adivd15/LaserScanner/README.md

# LaserScanner
College Optoelectronics Project
