adivd15/LaserScanner/HARDWARE/MECHANICS/Asembly/Motor_small_and_plate.SLDASM

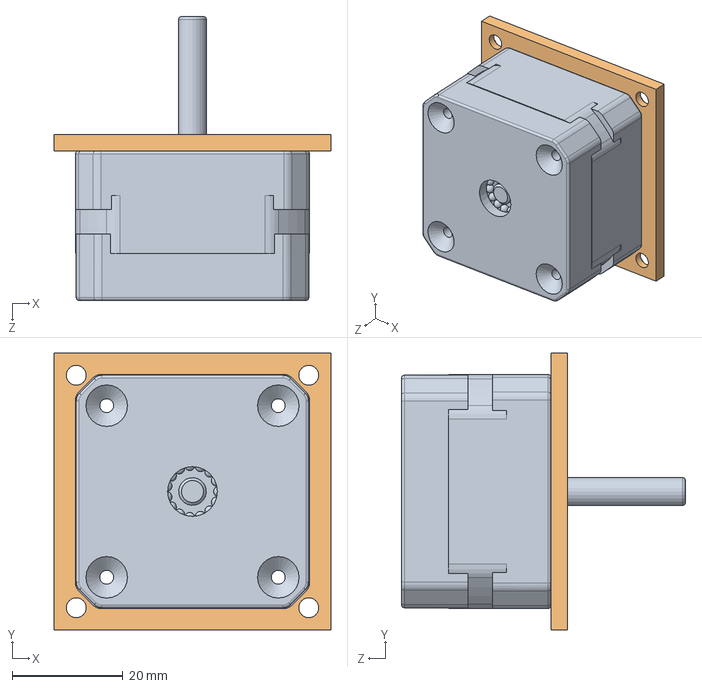
[picture p23: CAD file, 2022-12-18]
HARDWARE/MECHANICS/Asembly/Motor_small_and_plate.SLDASM
50.0 x 50.0 x 51.3 mm
NEMA_17_PHB42S28-406A v2
Plate
