adivd15/LaserScanner/HARDWARE/MECHANICS/Asembly/Motor_big_and_plate.SLDASM

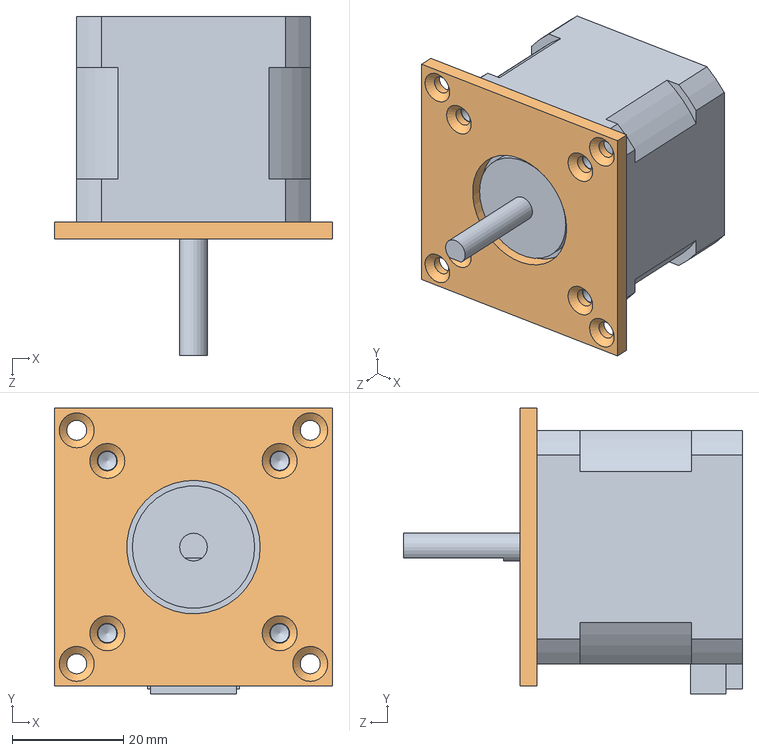
[picture p24: CAD file, 2022-12-18]
HARDWARE/MECHANICS/Asembly/Motor_big_and_plate.SLDASM
50.0 x 51.4 x 61.0 mm
NEMA17-42A02C-Body.step
Plate
