adivd15/LaserScanner/HARDWARE/MECHANICS/Asembly/Motors_and_base.SLDASM

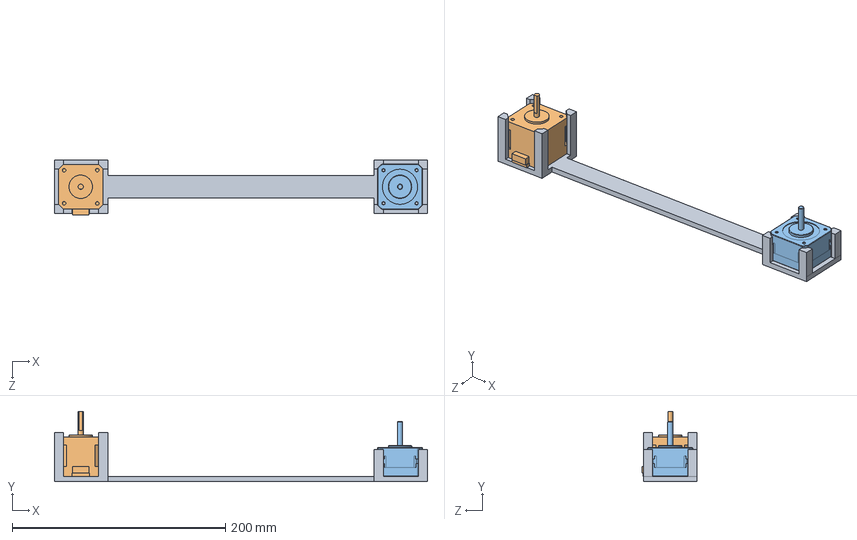
[picture p25: CAD file, 2022-12-18]
HARDWARE/MECHANICS/Asembly/Motors_and_base.SLDASM
350.0 x 66.0 x 51.4 mm
Base
NEMA17-42A02C-Body.step
NEMA_17_PHB42S28-406A v2
