adivd15/LaserScanner/HARDWARE/MECHANICS/Asembly/Scanner.SLDASM

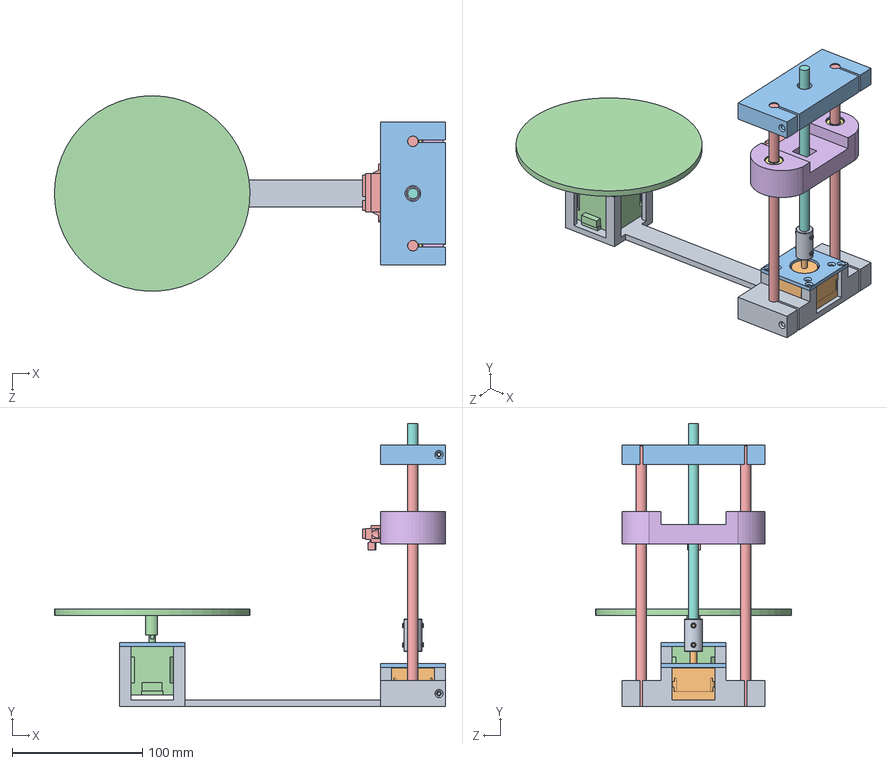
[picture p26: CAD file, 2022-12-18]
HARDWARE/MECHANICS/Asembly/Scanner.SLDASM
300.0 x 217.3 x 150.0 mm
Base
NEMA_17_PHB42S28-406A v2
Plate x 2
NEMA17-42A02C-Body.step
Axle x 2
Sensor_Mount
3.Linear Bearing-LM8UU.step x 2
Threaded_rod_8mm
Shaft Coupler.step
M4 x 4mm Cup-Point Set Screw.step x 4
Retention_hat
Scanner_plate
Long Range SHARP IR Sensors - #GP2Y0A21YK0F.step
