adivd15/LaserScanner/HARDWARE/MECHANICS/External parts/Long Range SHARP IR Sensors - #GP2Y0A21YK0F.STEP

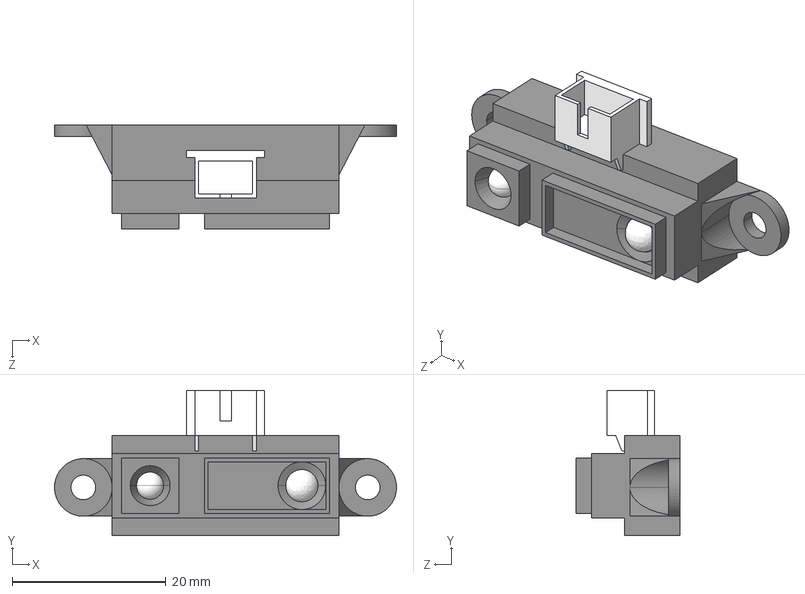
[picture p27: CAD file, 2022-12-18]
HARDWARE/MECHANICS/External parts/Long Range SHARP IR Sensors - #GP2Y0A21YK0F.STEP
44.5 x 18.9 x 13.5 mm
