adivd15/LaserScanner/HARDWARE/MECHANICS/Parts/Axle.SLDPRT

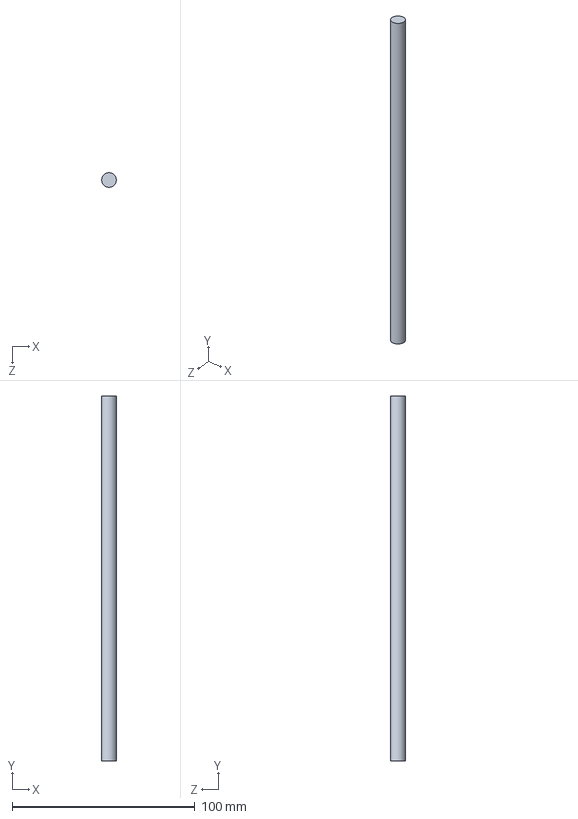
[picture p28: CAD file, 2022-12-18]
HARDWARE/MECHANICS/Parts/Axle.SLDPRT
8.00 x 200.0 x 8.00 mm
