adivd15/LaserScanner/HARDWARE/MECHANICS/To be 3D printed/base_first_half.stl

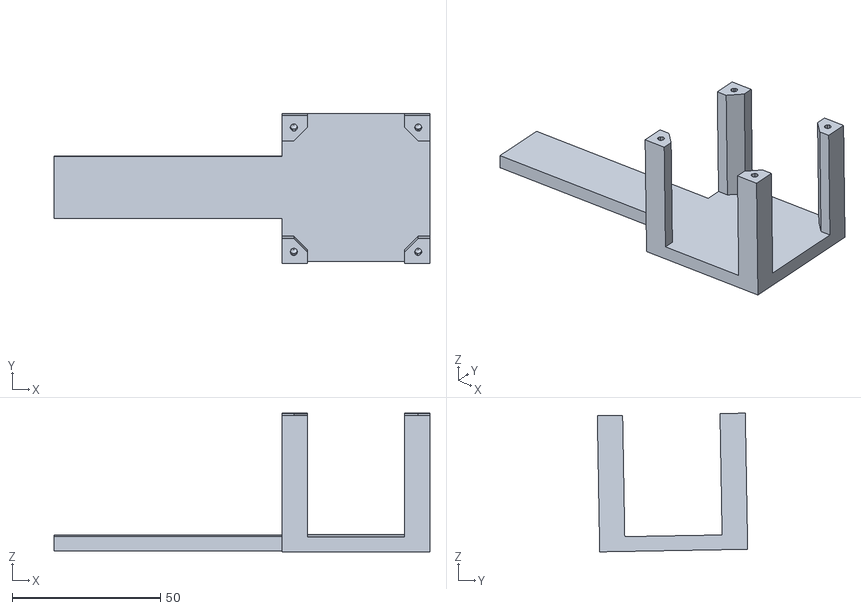
[picture p29: CAD file, 2022-12-18]
HARDWARE/MECHANICS/To be 3D printed/base_first_half.stl
127.0 x 50.8 x 46.9
