adivd15/LaserScanner/HARDWARE/MECHANICS/External parts/NEMA17-42A0C.step

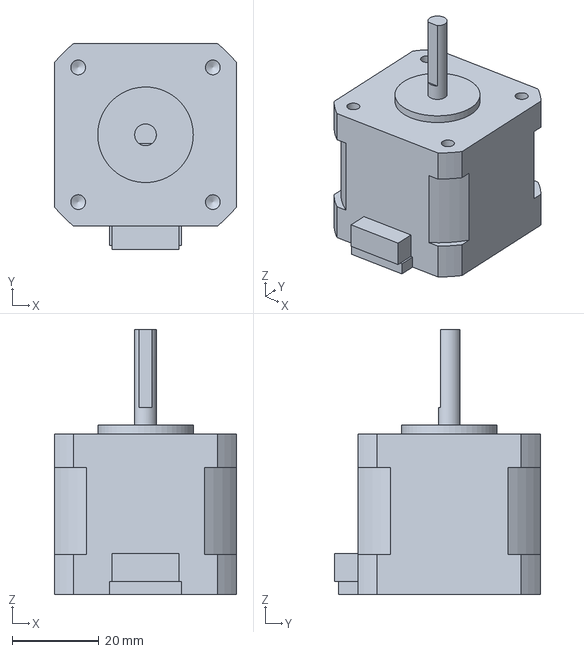
[picture p30: CAD file, 2022-12-18]
HARDWARE/MECHANICS/External parts/NEMA17-42A0C.step
42.0 x 47.4 x 61.0 mm
