adivd15/LaserScanner/HARDWARE/MECHANICS/Parts/Scanner_plate.SLDPRT

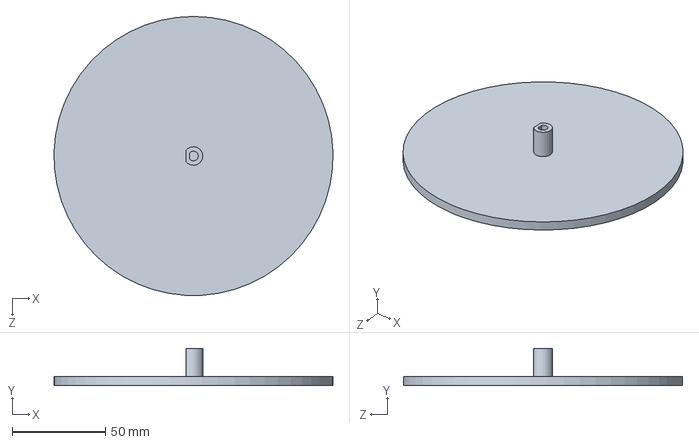
[picture p31: CAD file, 2022-12-18]
HARDWARE/MECHANICS/Parts/Scanner_plate.SLDPRT
149.9 x 20.0 x 150.0 mm
