adivd15/LaserScanner/HARDWARE/MECHANICS/To be 3D printed/Base_second_half_update_2.stl

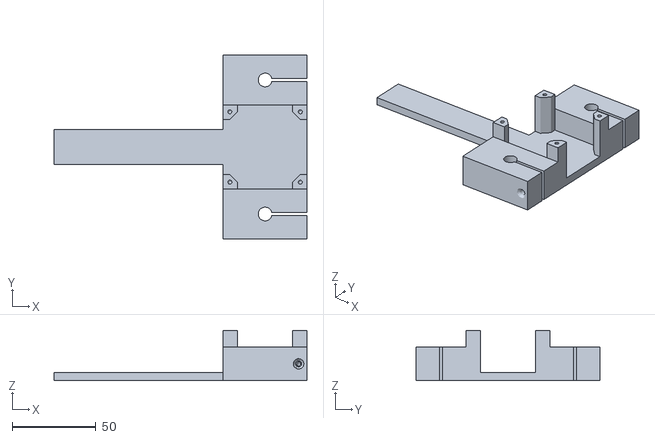
[picture p32: CAD file, 2022-12-18]
HARDWARE/MECHANICS/To be 3D printed/Base_second_half_update_2.stl
151.0 x 110.0 x 30.0
