adivd15/LaserScanner/HARDWARE/MECHANICS/External parts/NEMA_17_PHB42S28-406A v2.step

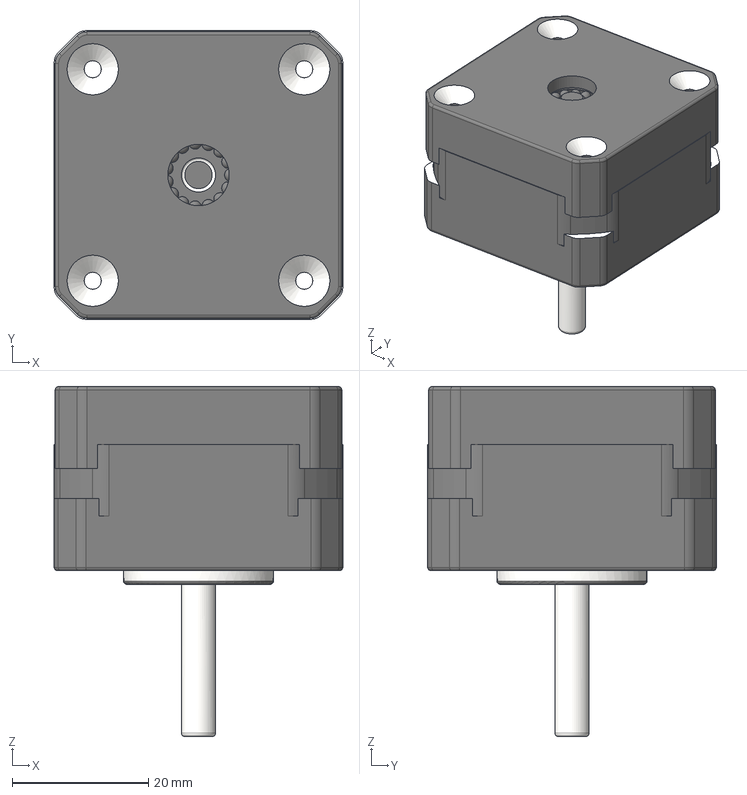
[picture p33: CAD file, 2022-12-18]
HARDWARE/MECHANICS/External parts/NEMA_17_PHB42S28-406A v2.step
42.3 x 42.3 x 51.3 mm
