adivd15/LaserScanner/HARDWARE/MECHANICS/Parts/Base.SLDPRT

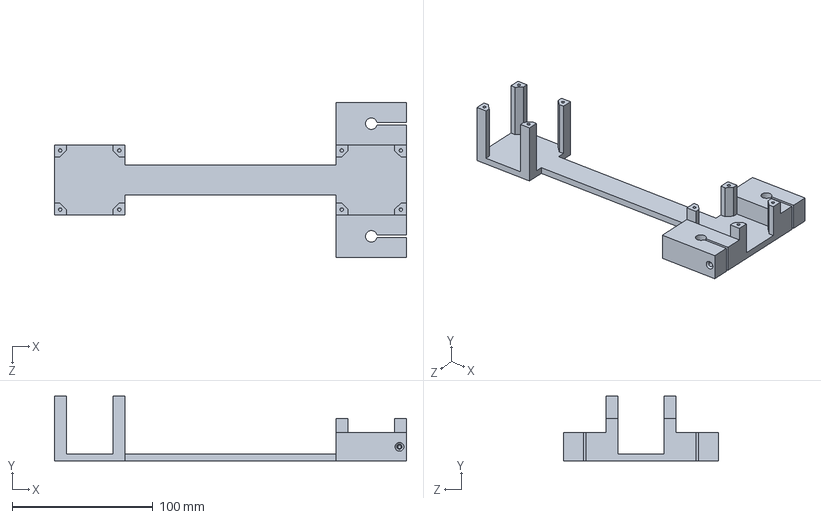
[picture p34: CAD file, 2022-12-18]
HARDWARE/MECHANICS/Parts/Base.SLDPRT
250.0 x 46.0 x 110.0 mm
