adivd15/LaserScanner/HARDWARE/MECHANICS/To be 3D printed/Base_second_hals.stl

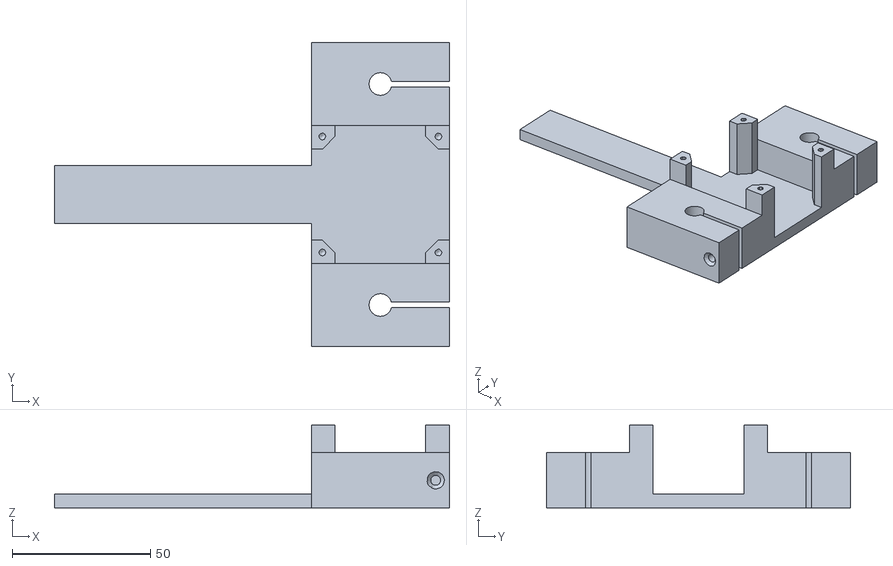
[picture p35: CAD file, 2022-12-18]
HARDWARE/MECHANICS/To be 3D printed/Base_second_hals.stl
143.0 x 110.0 x 30.0
