adivd15/LaserScanner/HARDWARE/MECHANICS/External parts/3.Linear Bearing-LM8UU.STEP

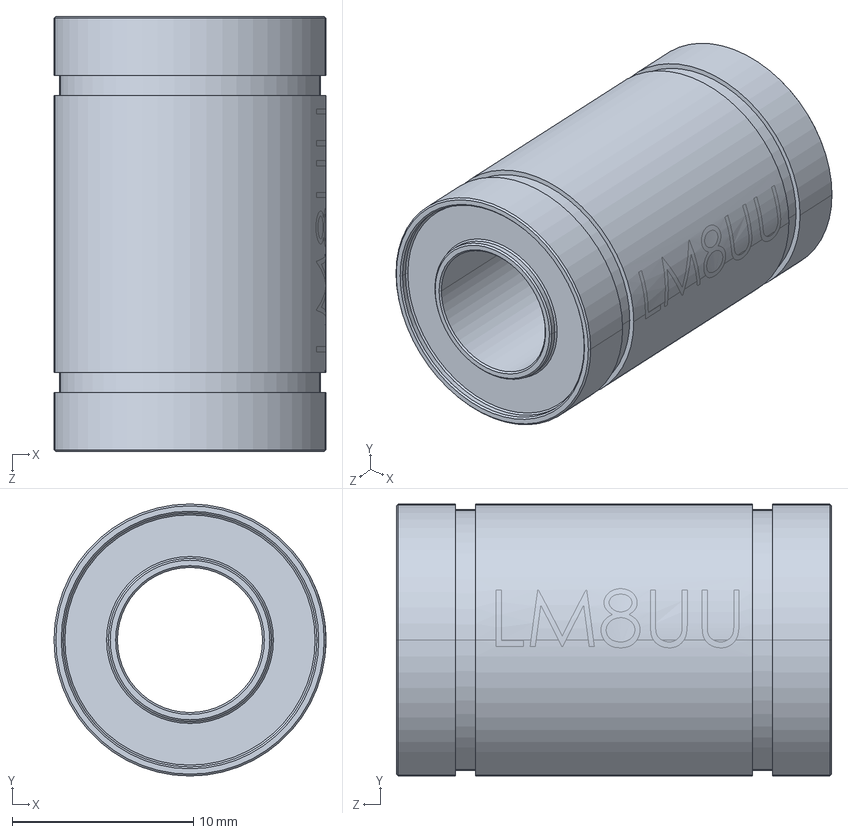
[picture p36: CAD file, 2022-12-18]
HARDWARE/MECHANICS/External parts/3.Linear Bearing-LM8UU.STEP
15.0 x 15.0 x 24.0 mm
