adivd15/LaserScanner/HARDWARE/MECHANICS/Parts/Retention_hat.SLDPRT

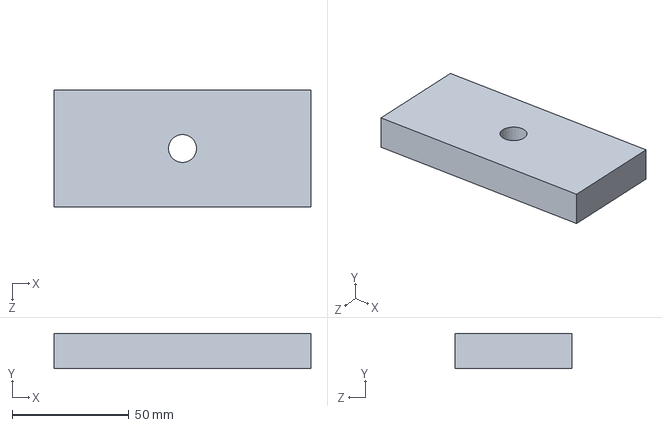
[picture p37: CAD file, 2022-12-18]
HARDWARE/MECHANICS/Parts/Retention_hat.SLDPRT
110.0 x 15.0 x 50.0 mm
