adivd15/LaserScanner/HARDWARE/MECHANICS/To be 3D printed/Base.STL

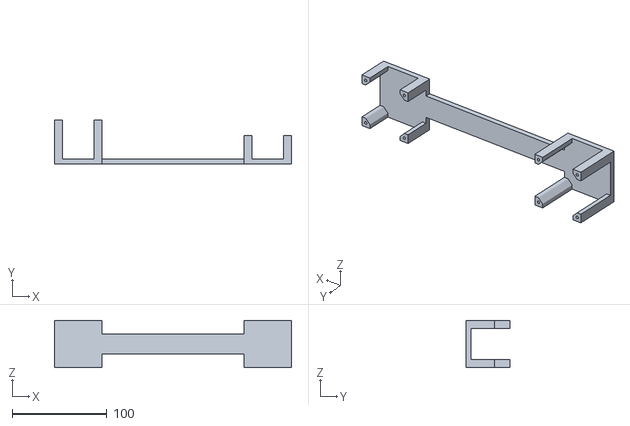
[picture p38: CAD file, 2022-12-18]
HARDWARE/MECHANICS/To be 3D printed/Base.STL
250.0 x 46.0 x 50.0
