adivd15/LaserScanner/HARDWARE/MECHANICS/External parts/Shaft Coupler_5 - 8 mm.step

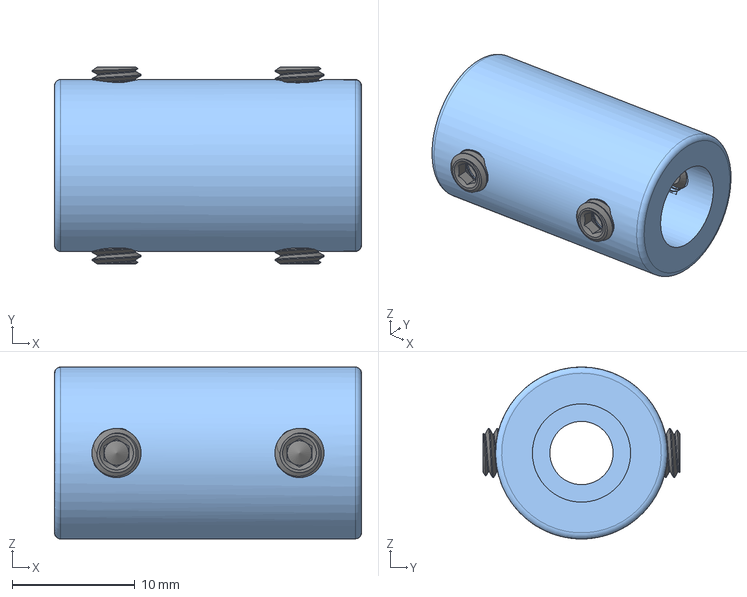
[picture p39: CAD file, 2022-12-18]
HARDWARE/MECHANICS/External parts/Shaft Coupler_5 - 8 mm.step
25.0 x 16.0 x 14.0 mm
Shaft Coupler
M4 x 4mm Cup-Point Set Screw x 4
