adivd15/LaserScanner/HARDWARE/MECHANICS/Parts/Sensor_Mount.SLDPRT

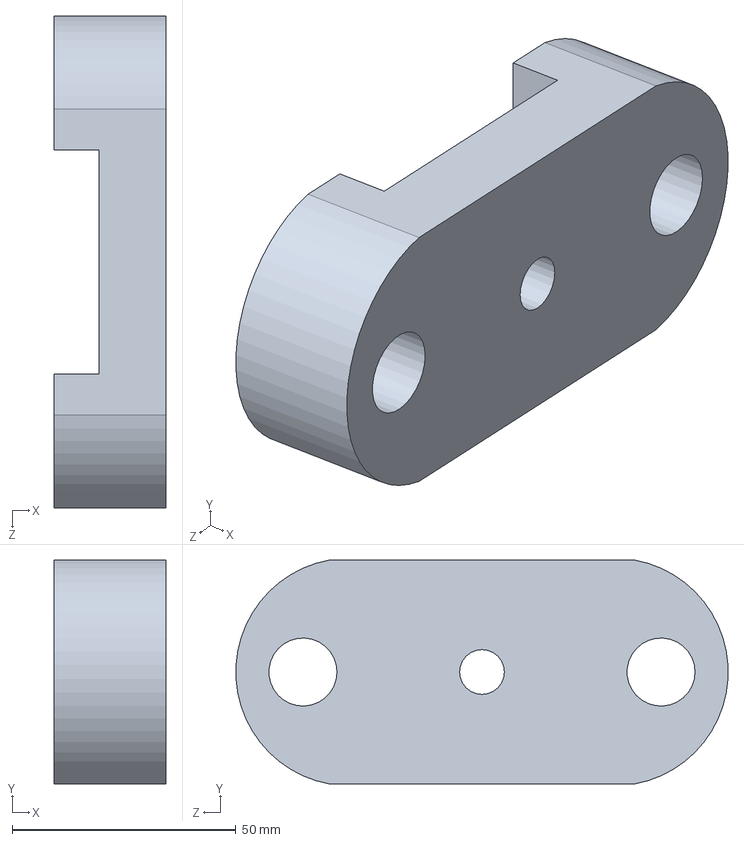
[picture p40: CAD file, 2022-12-18]
HARDWARE/MECHANICS/Parts/Sensor_Mount.SLDPRT
25.0 x 50.0 x 109.9 mm
