adivd15/LaserScanner/HARDWARE/MECHANICS/Parts/Plate.SLDPRT

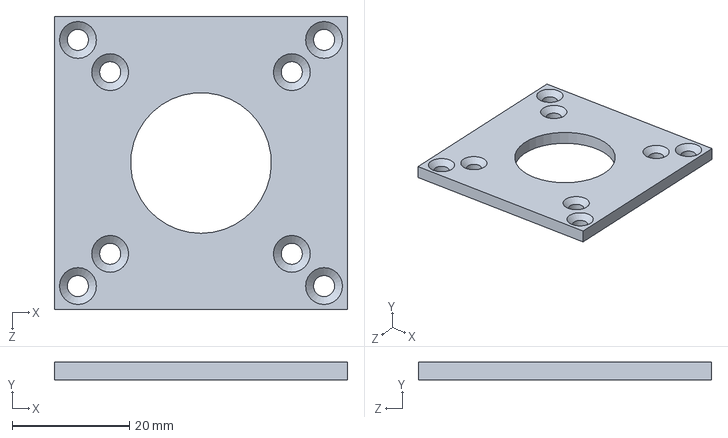
[picture p41: CAD file, 2022-12-18]
HARDWARE/MECHANICS/Parts/Plate.SLDPRT
50.0 x 3.00 x 50.0 mm
