adivd15/LaserScanner/HARDWARE/MECHANICS/To be 3D printed/Retention_hat.STL

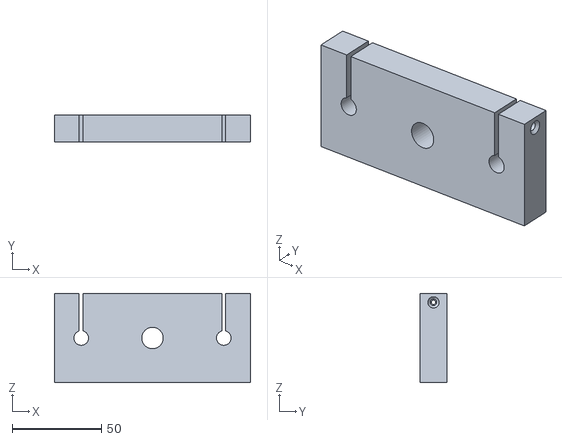
[picture p42: CAD file, 2022-12-18]
HARDWARE/MECHANICS/To be 3D printed/Retention_hat.STL
110.0 x 15.0 x 50.0
