adivd15/LaserScanner/HARDWARE/MECHANICS/Parts/B18.2.4.1M - Hex nut, Style 1,  M6 x 1 --D-N.SLDPRT

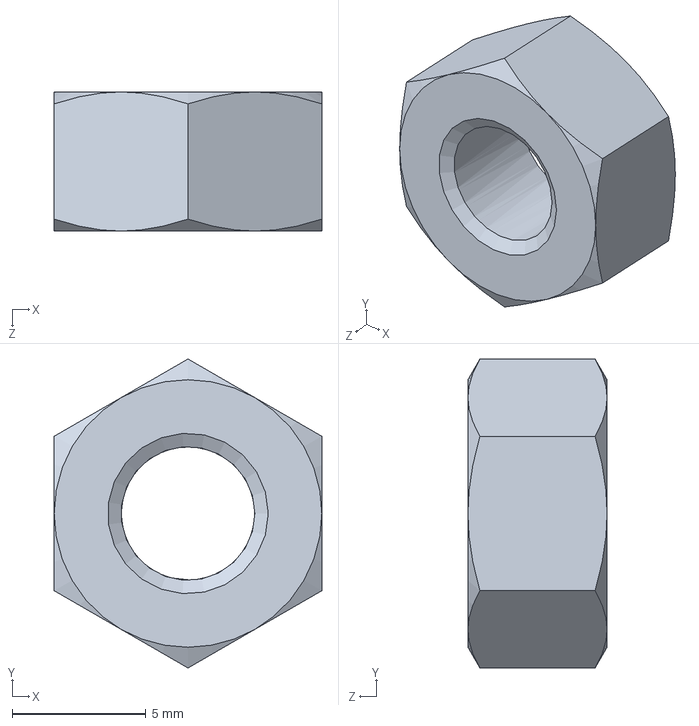
[picture p43: CAD file, 2022-12-18]
HARDWARE/MECHANICS/Parts/B18.2.4.1M - Hex nut, Style 1, M6 x 1 --D-N.SLDPRT
10.0 x 11.5 x 5.20 mm
