adivd15/LaserScanner/HARDWARE/MECHANICS/Parts/Threaded_rod_8mm.SLDPRT

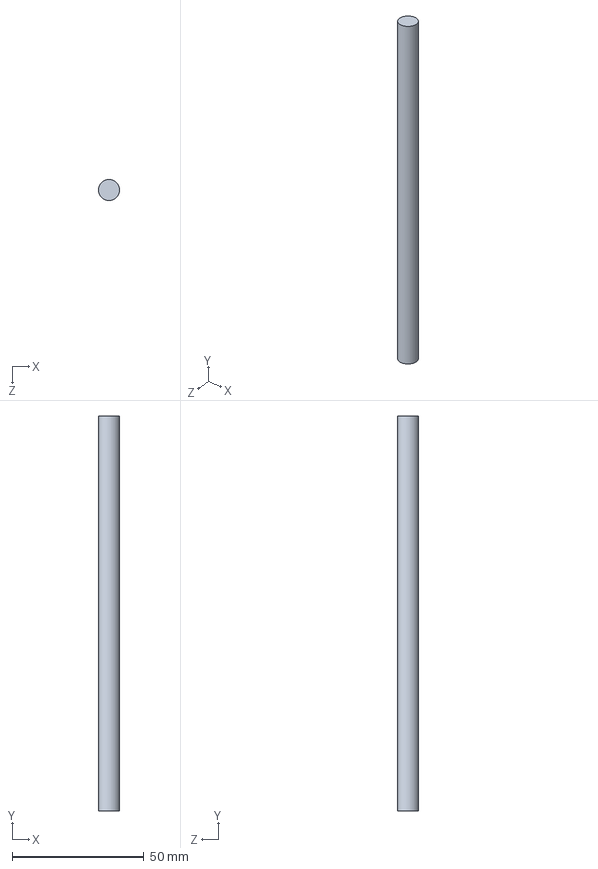
[picture p44: CAD file, 2022-12-18]
HARDWARE/MECHANICS/Parts/Threaded_rod_8mm.SLDPRT
8.00 x 150.0 x 8.00 mm
