adivd15/LaserScanner/(list of files, cad)

Other CAD files:
HARDWARE/MECHANICS/To be 3D printed/Base_updated.STL
HARDWARE/MECHANICS/To be 3D printed/Sensor_Mount.STL
HARDWARE/MECHANICS/To be 3D printed/Base_update_2.STL
HARDWARE/MECHANICS/To be 3D printed/Plate.STL
HARDWARE/MECHANICS/To be 3D printed/Scanner_plate.STL
HARDWARE/MECHANICS/External parts/NEMA17-42A0C.SLDASM
HARDWARE/MECHANICS/External parts/NEMA_17_PHB42S28-406A v2.SLDPRT
