adivd15/LaserScanner/HARDWARE/ELECTRONICS/Laser_scanner_schematic.brd

## EAGLE design HARDWARE/ELECTRONICS/Laser_scanner_schematic.brd (2022-12-18)

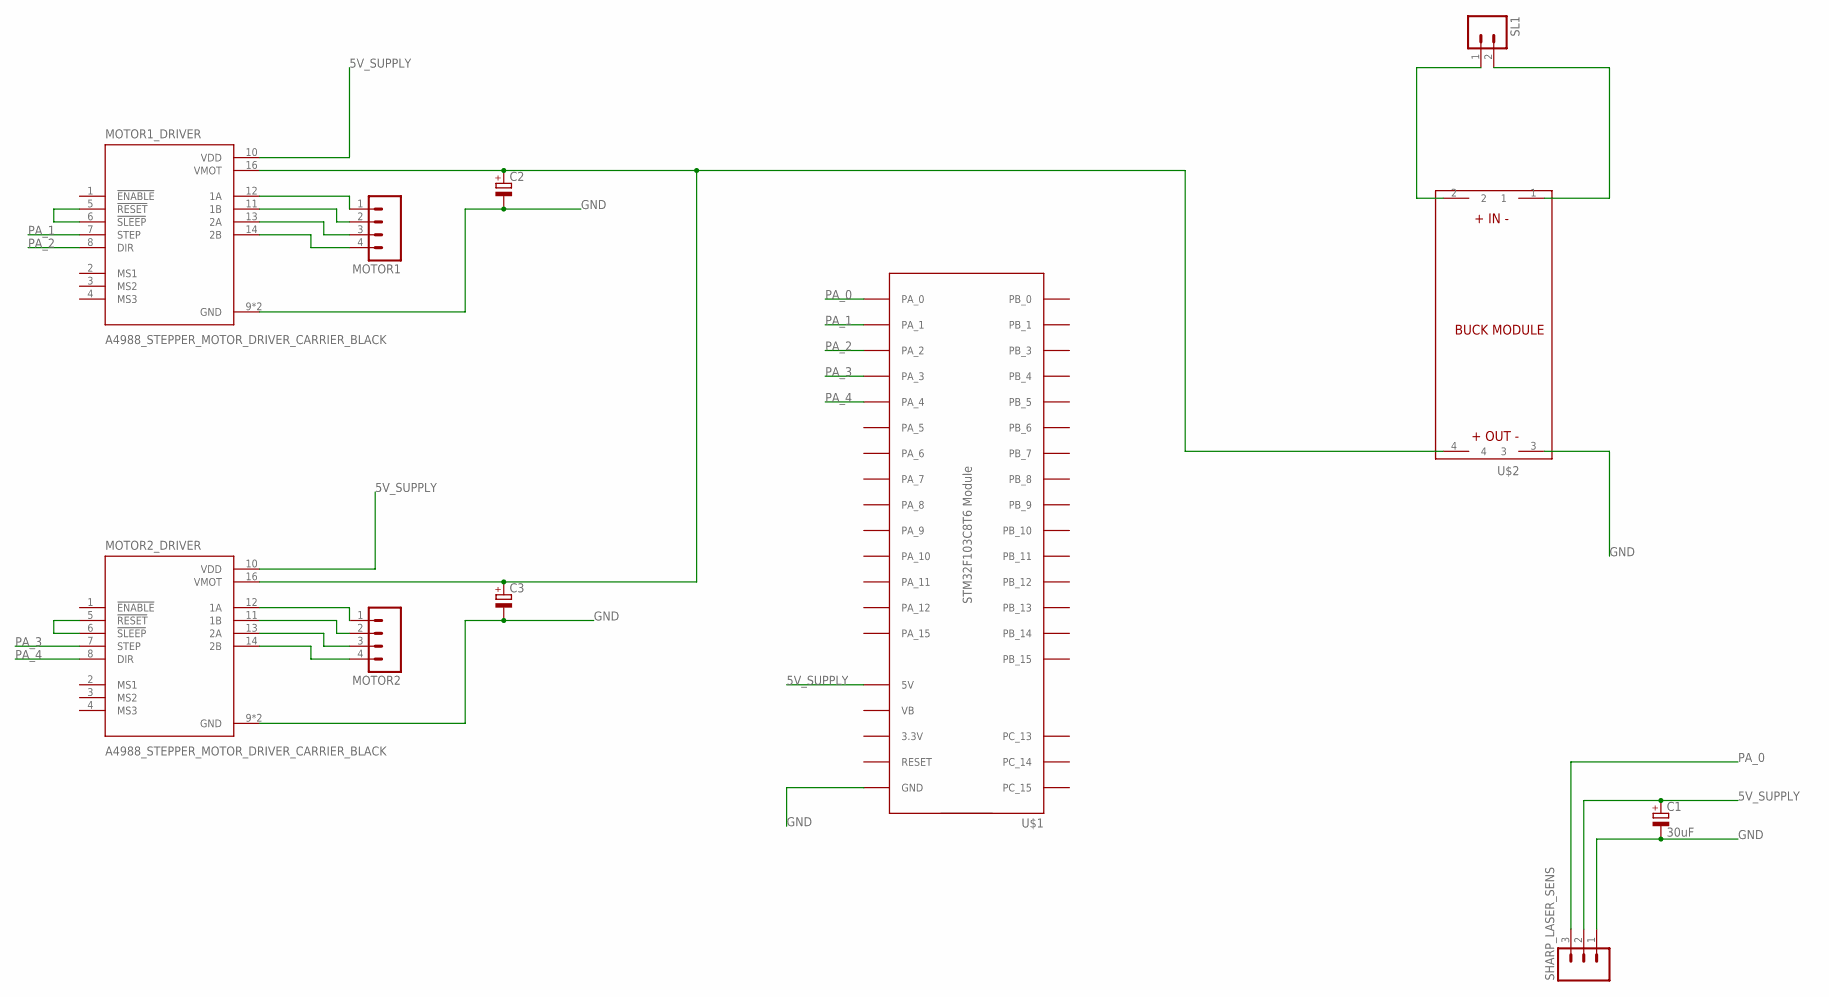
[picture p45: schematic Laser_scanner_schematic.sch]

Parts:
C1: 30uF; E2-4
C2, C3: CPOL-EUE2-5; E2-5
MOTOR1, MOTOR2: M04; 04P
MOTOR1_DRIVER, MOTOR2_DRIVER: A4988_STEPPER_MOTOR_DRIVER_CARRIER_BLACK; MODULE_A4988_STEPPER_MOTOR_DRIVER_CARRIER_BLACK
SHARP_LASER_SENS: M03; 03P
SL1: M02; 02P
U$1: STM32F103C8T6-MODULE
U$2: BUCK_MODULEWITH_SMDPADS&THROUGHHOLES; BUCK_MODULE

Connections:
5V_SUPPLY: C1.+, MOTOR1_DRIVER.10 (VDD), MOTOR2_DRIVER.10 (VDD), SHARP_LASER_SENS.2, U$1.5V
GND: C1.-, C2.-, C3.-, MOTOR1_DRIVER.9 (GND), MOTOR1_DRIVER.15 (GND), MOTOR2_DRIVER.9 (GND), MOTOR2_DRIVER.15 (GND), SHARP_LASER_SENS.1, U$1.GND@1 (GND), U$1.GND@2 (GND), U$1.GND@3 (GND), U$2.3
unnamed: MOTOR1.1, MOTOR1_DRIVER.12 (1A)
unnamed: MOTOR1.2, MOTOR1_DRIVER.11 (1B)
unnamed: MOTOR1_DRIVER.5 (!RESET), MOTOR1_DRIVER.6 (!SLEEP)
unnamed: MOTOR2_DRIVER.5 (!RESET), MOTOR2_DRIVER.6 (!SLEEP)
unnamed: MOTOR1.3, MOTOR1_DRIVER.13 (2A)
unnamed: MOTOR1.4, MOTOR1_DRIVER.14 (2B)
unnamed: MOTOR2.1, MOTOR2_DRIVER.12 (1A)
unnamed: MOTOR2.2, MOTOR2_DRIVER.11 (1B)
unnamed: MOTOR2.3, MOTOR2_DRIVER.13 (2A)
unnamed: MOTOR2.4, MOTOR2_DRIVER.14 (2B)
unnamed: SL1.1, U$2.2
unnamed: SL1.2, U$2.1
unnamed: C2.+, C3.+, MOTOR1_DRIVER.16 (VMOT), MOTOR2_DRIVER.16 (VMOT), U$2.4
PA_0: SHARP_LASER_SENS.3, U$1.PA_0
PA_1: MOTOR1_DRIVER.7 (STEP), U$1.PA_1
PA_2: MOTOR1_DRIVER.8 (DIR), U$1.PA_2
PA_3: MOTOR2_DRIVER.7 (STEP), U$1.PA_3
PA_4: MOTOR2_DRIVER.8 (DIR), U$1.PA_4

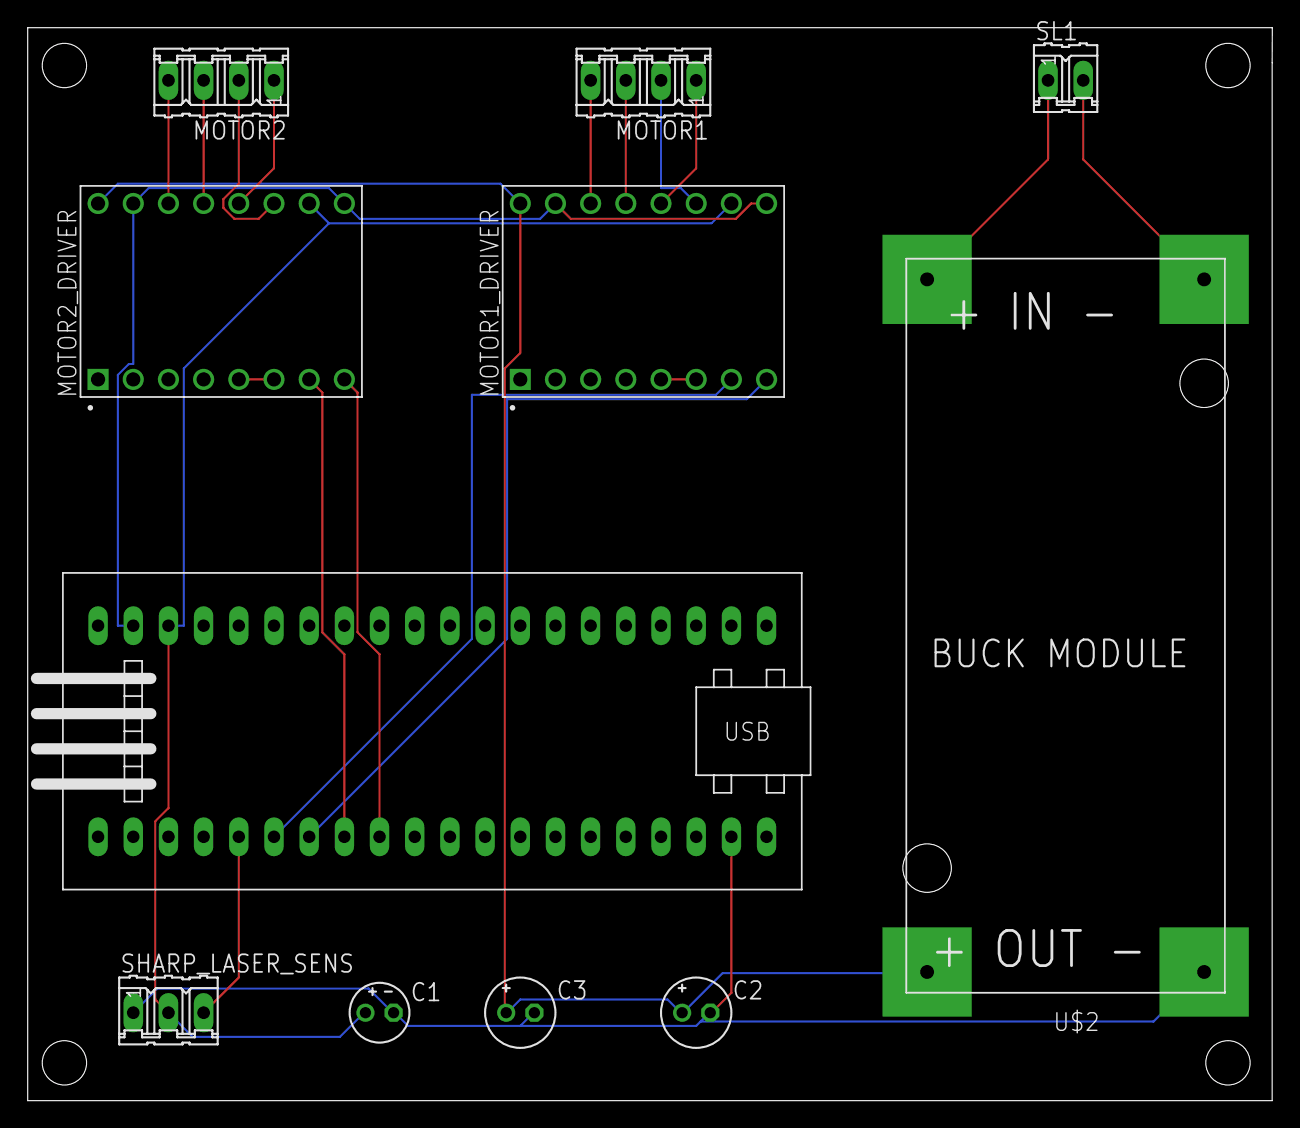
[picture p46: board Laser_scanner_schematic.brd from above]

Board: 2 copper layers, 89.9 x 77.5 mm, 11 parts (0 on the bottom side), 20 nets.
