adivd15/LaserScanner/SOFTWARE/uC_prj/Core/Inc/main.h

#define Motor1_dirPin_Pin GPIO_PIN_3
#define Motor1_dirPin_GPIO_Port GPIOA
#define Motor1_stepPin_Pin GPIO_PIN_4
#define Motor1_stepPin_GPIO_Port GPIOA
#define Motor2_dirPin_Pin GPIO_PIN_5
#define Motor2_dirPin_GPIO_Port GPIOA
#define Motor2_stepPin_Pin GPIO_PIN_6
#define Motor2_stepPin_GPIO_Port GPIOA
