adivd15/LaserScanner/SOFTWARE/uC_prj/Core/Src/main.c

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
/* Includes ------------------------------------------------------------------*/
#include "main.h"
#include "usb_device.h"

/* USER CODE BEGIN Includes */
#include <math.h>

#include <srv_sens_api.h>
#include <srv_sens_swcpma.h>
#include <srv_sens_def.h>
#include <srv_MotorControl_main.h>
/* USER CODE END Includes */

/* USER CODE BEGIN PTD */
typedef struct poin_coord{
    float x;
    float y;
    float z;

    int x_dec;
    int y_dec;
    int z_dec;

    int x_int;
    int y_int;
    int z_int;
} poin_coord;
/* USER CODE END PTD */

ADC_HandleTypeDef hadc1;

void SystemClock_Config(void);
static void MX_GPIO_Init(void);
static void MX_ADC1_Init(void);
/**
  * @brief  The application entry point.
  * @retval int
  */
int main(void)
{
  /* USER CODE BEGIN 1 */
  uint8_t msg[50];
  poin_coord point;
  float alpha = 0;
  /* USER CODE END 1 */

  /* MCU Configuration--------------------------------------------------------*/

  /* Reset of all peripherals, Initializes the Flash interface and the Systick. */
  HAL_Init();

  /* Configure the system clock */
  SystemClock_Config();

  /* Initialize all configured peripherals */
  MX_GPIO_Init();
  MX_ADC1_Init();
  MX_USB_DEVICE_Init();
  /* USER CODE BEGIN 2 */
  srv_sens_init();
  set_adc(&hadc1);
  motorControl_init();
  sensor_data_t sens_readings;
  /* USER CODE END 2 */

  /* Infinite loop */
  /* USER CODE BEGIN WHILE */
  while (1)
  {
    /* USER CODE END WHILE */
    float angle_rad = 0;
    HAL_Delay(4000);
    CDC_Transmit_FS("Waiting a litlle bit to start\r\n",32);
    point.z = 0;
    for(int i = 0; i < 260; i++){
      for(int i = 0; i < 40; i++){
        srv_sens_main();
        sens_readings = get_sensor_data();
        point.x = (19.0-sens_readings.sensor_data)*sin(alpha);
        point.y = (19.0-sens_readings.sensor_data)*cos(alpha);

        point.x_int = (int)point.x;
        point.y_int = (int)point.y;
        point.z_int = (int)point.z;

        if(point.x<0){
          point.x_dec = -1*(int)((point.x - point.x_int)*1000);
        }
        else{
          point.x_dec = (int)((point.x - point.x_int)*1000);
        }
        if(point.y<0){
          point.y_dec = -1*(int)((point.y - point.y_int)*1000);
        }
        else{
          point.y_dec = (int)((point.y - point.y_int)*1000);
        }
        point.z_dec = (int)((point.z - point.z_int)*1000);
        
        sprintf(msg,"%d.%d, %d.%d, %d.%d\r\n",point.x_int,point.x_dec,point.y_int,point.y_dec,point.z_int,point.z_dec);
        //sprintf(msg,"%d.%d\r\n",sens_readings.sensor_decimal,sens_readings.sensor_unit);
        //sprintf(msg,"%d.%d\r\n",(int)alpha,(int)((alpha - (int)alpha)*1000));
        //sprintf(msg,"%d.%d\r\n",point.x_int,point.x_dec);
        //sprintf(msg,"%d.%d\r\n",sens_readings.sensor_decimal,sens_readings.sensor_unit);
        CDC_Transmit_FS(msg,strlen(msg));
        motorControl_spin4Steps();
        alpha = alpha + 0.157;
        HAL_Delay(10);
      }
      motorControlSens_spin4Steps();
      point.z = point.z + 0.2;

    }
    
    
    alpha = 0;
    /* USER CODE BEGIN 3 */
  }
  /* USER CODE END 3 */
}

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
