adivd15/LaserScanner/SOFTWARE/uC_prj/Layers/SRV_MotorControl/INC/SRV_MotorControl_config.h

#ifndef SRV_MOTORCONTROL_CONFIG_H_
#define SRV_MOTORCONTROL_CONFIG_H_

/*
    MOTOR 1
*/
#define Motor1_dirPin GPIO_PIN_3
#define Motor1_dirPort GPIOA
#define Motor1_stepPin GPIO_PIN_4
#define Motor1_stepPort GPIOA
/*
    MOTOR 2
*/
#define Motor2_dirPin GPIO_PIN_5
#define Motor2_dirPort GPIOA
#define Motor2_stepPin GPIO_PIN_6
#define Motor2_stepPort GPIOA

#endif
