adivd15/LaserScanner/(commit log)

2022-10-19 Managed to spin motor
2022-11-03 Fixed motor port selection
    [SRV_MotorControl_main.c]
2022-12-08 finished motor_control_module
2022-12-18 Finished release
    [3.Linear Bearing-LM8UU.STEP, Axle.SLDPRT, B18.2.4.1M - Hex nut, Style 1, M6 x 1 --D-N.SLDPRT, Base.SLDPRT, Base.STL, Base_second_half_update_2.stl, Base_second_hals.stl, Base_update_2.STL]
